qrellw/RR-Laser-Circuit/receiver/receiver-B_Cu_page-0001.jpg

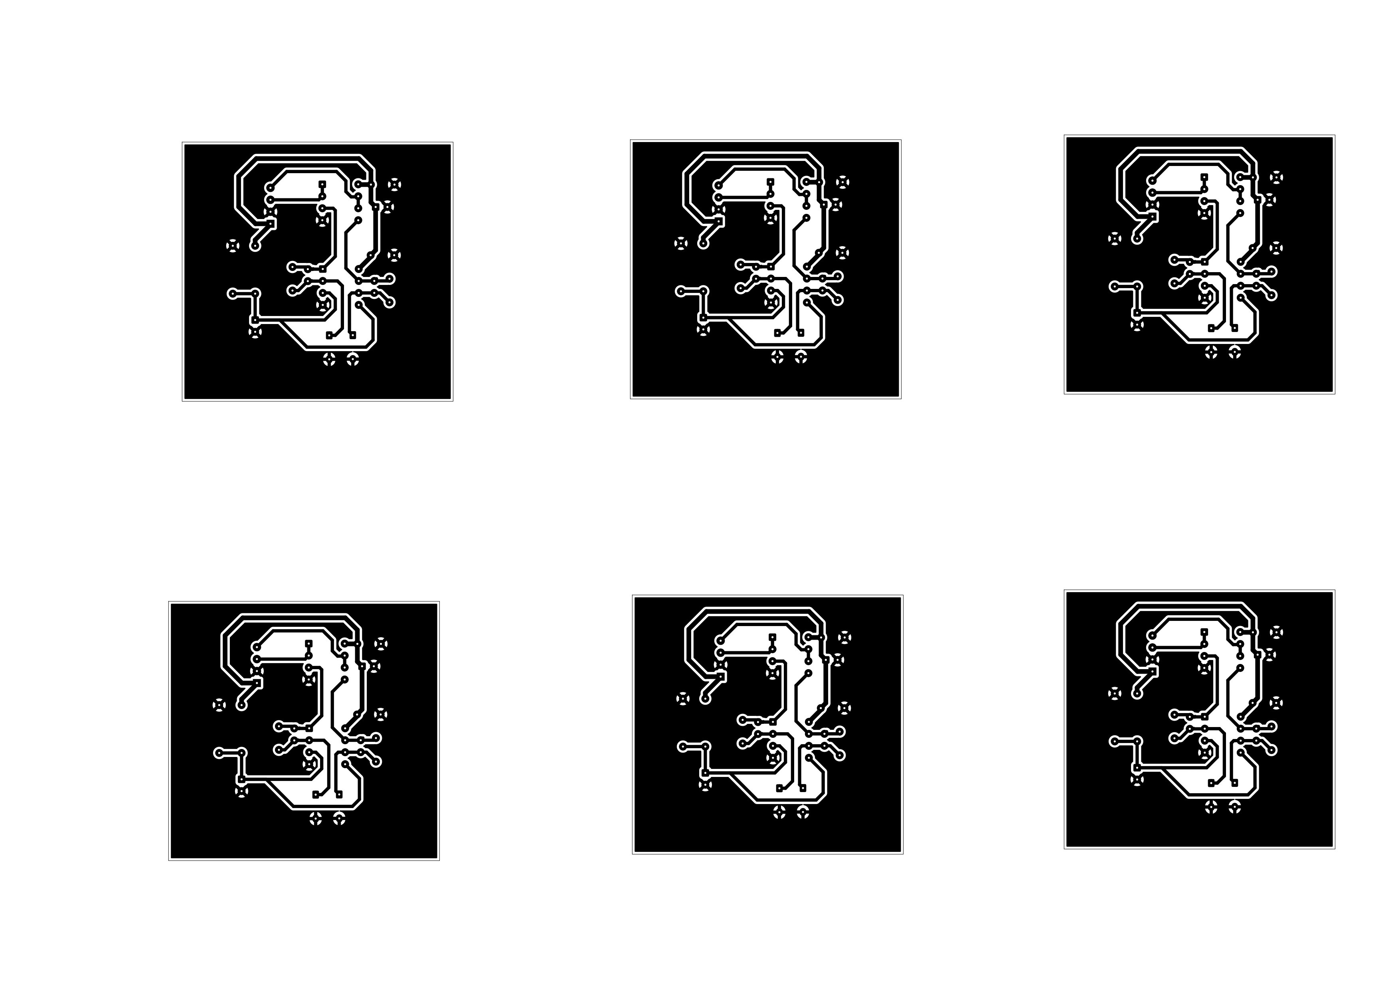
receiver/receiver-B_Cu_page-0001.jpg
