qrellw/RR-Laser-Circuit/receiver/bpw34-1.snapshot.1/bpw34.STEP

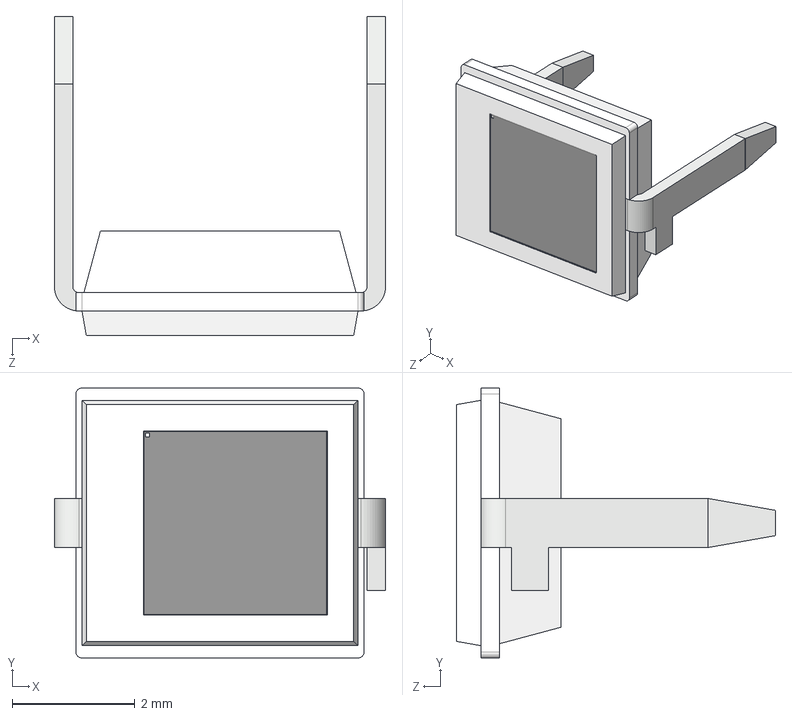
[picture p2: CAD file, 2026-10-17]
receiver/bpw34-1.snapshot.1/bpw34.STEP
5.40 x 4.40 x 5.20 mm
footA
footB
