qrellw/RR-Laser-Circuit/RR_Lightdistance/RR_Lightdistance.step

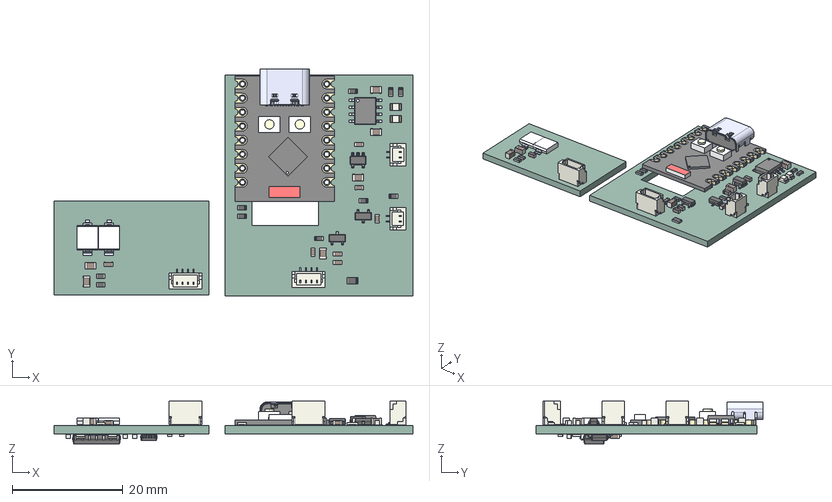
[picture p3: CAD file, 2026-10-30]
RR_Lightdistance/RR_Lightdistance.step
64.9 x 41.1 x 7.75 mm
C_0603_1608Metric x 12
JST_SH_BM02B-SRSS-TB_1x02-1MP_P1.00mm_Vertical x 2
C_0805_2012Metric x 6
SOT-23 x 2
R_0603_1608Metric x 16
BPW 34 S-Z x 2
R_0805_2012Metric
SOT-23-5
LED_0805_2012Metric x 2
Board c3mini
USB C
components (other)^ESP32-C3 SuperMini
TP4056-42-ESOP8
JST_SH_BM04B-SRSS-TB_1x04-1MP_P1.00mm_Vertical x 2
TSSOP-10_3x3mm_P0.5mm
SOIC-14_3.9x8.7mm_P1.27mm
RR_7F92_PCB_1
RR_7F92_PCB_2
