qrellw/RR-Laser-Circuit/(list of files, cad)

Other CAD files:
receiver/bpw34-1.snapshot.1/bpw34.SLDASM
