qrellw/RR-Laser-Circuit/receiver/receiver-B_Cu.pdf

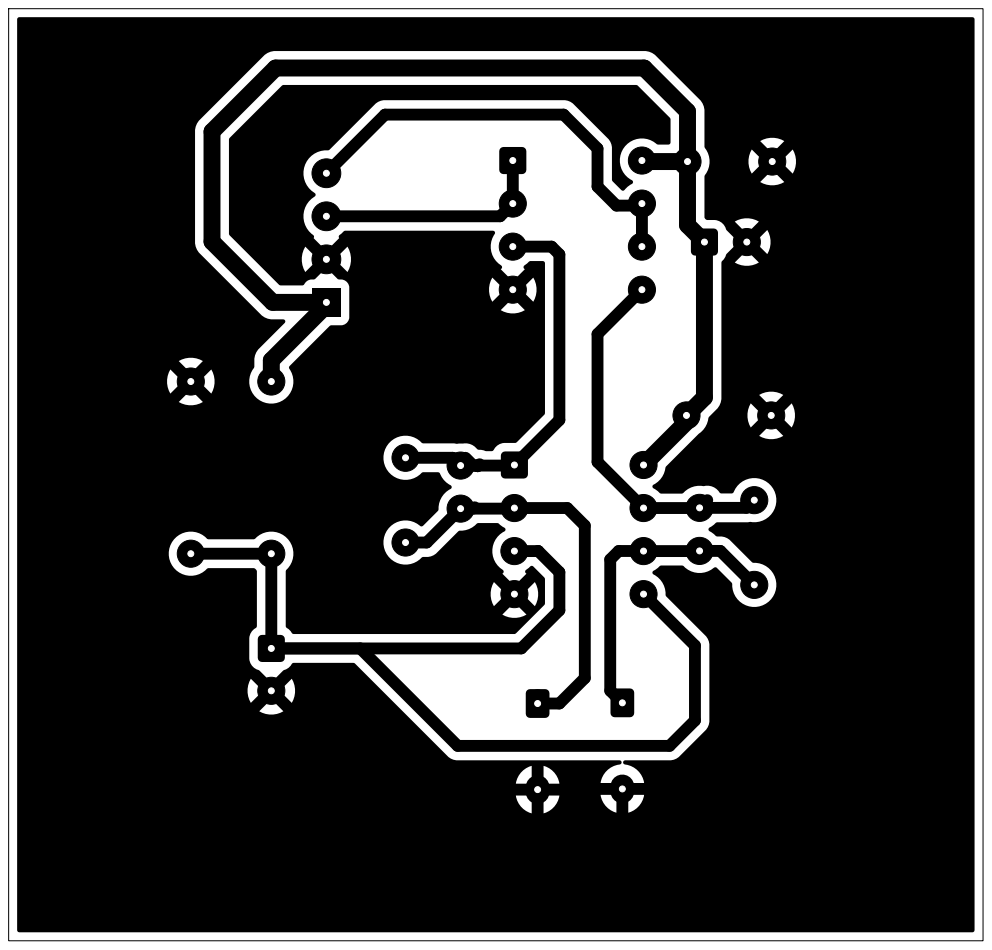
[picture p4: page 1]
