qrellw/RR-Laser-Circuit/RR_Lightdistance/RR_Lightdistance.kicad_pcb

## KiCad design RR_Lightdistance/RR_Lightdistance.kicad_pcb (2026-11-08)

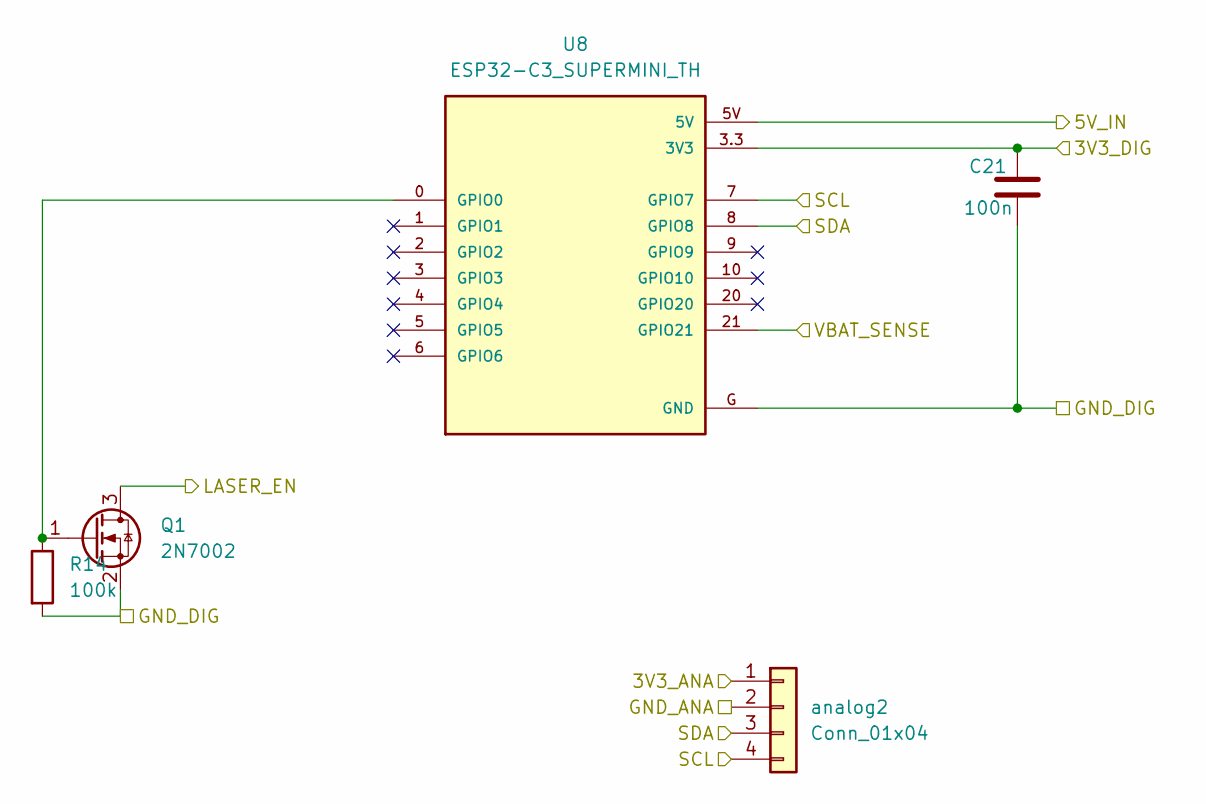
[picture p5: schematic digital.kicad_sch]

Parts:
C21: 100n; C_0603_1608Metric
Q1: 2N7002; SOT-23
R14: 100k; R_0603_1608Metric
U8: ESP32-C3_SUPERMINI_TH; MODULE_ESP32-C3_SUPERMINI_TH
analog2: Conn_01x04; JST_SH_BM04B-SRSS-TB_1x04-1MP_P1.00mm_Vertical

Connections:
/Analog/3V3_ANA: analog2.1; also elsewhere on the board
/Analog/GND_ANA: analog2.2; also elsewhere on the board
/Analog/SCL: U8.7 (GPIO7), analog2.4; also elsewhere on the board
/Analog/SDA: U8.8 (GPIO8), analog2.3; also elsewhere on the board
/Digital/3V3_DIG: C21.1, U8.3.3 (3V3); also elsewhere on the board
/Digital/5V_IN: U8.5V; also elsewhere on the board
/Digital/GND_DIG: C21.2, Q1.2 (S), R14.2, U8.G (GND); also elsewhere on the board
/Digital/LASER_EN: Q1.3 (D); also elsewhere on the board
/Digital/VBAT_SENSE: U8.21 (GPIO21); also elsewhere on the board
unnamed: Q1.1 (G), R14.1, U8.0 (GPIO0)

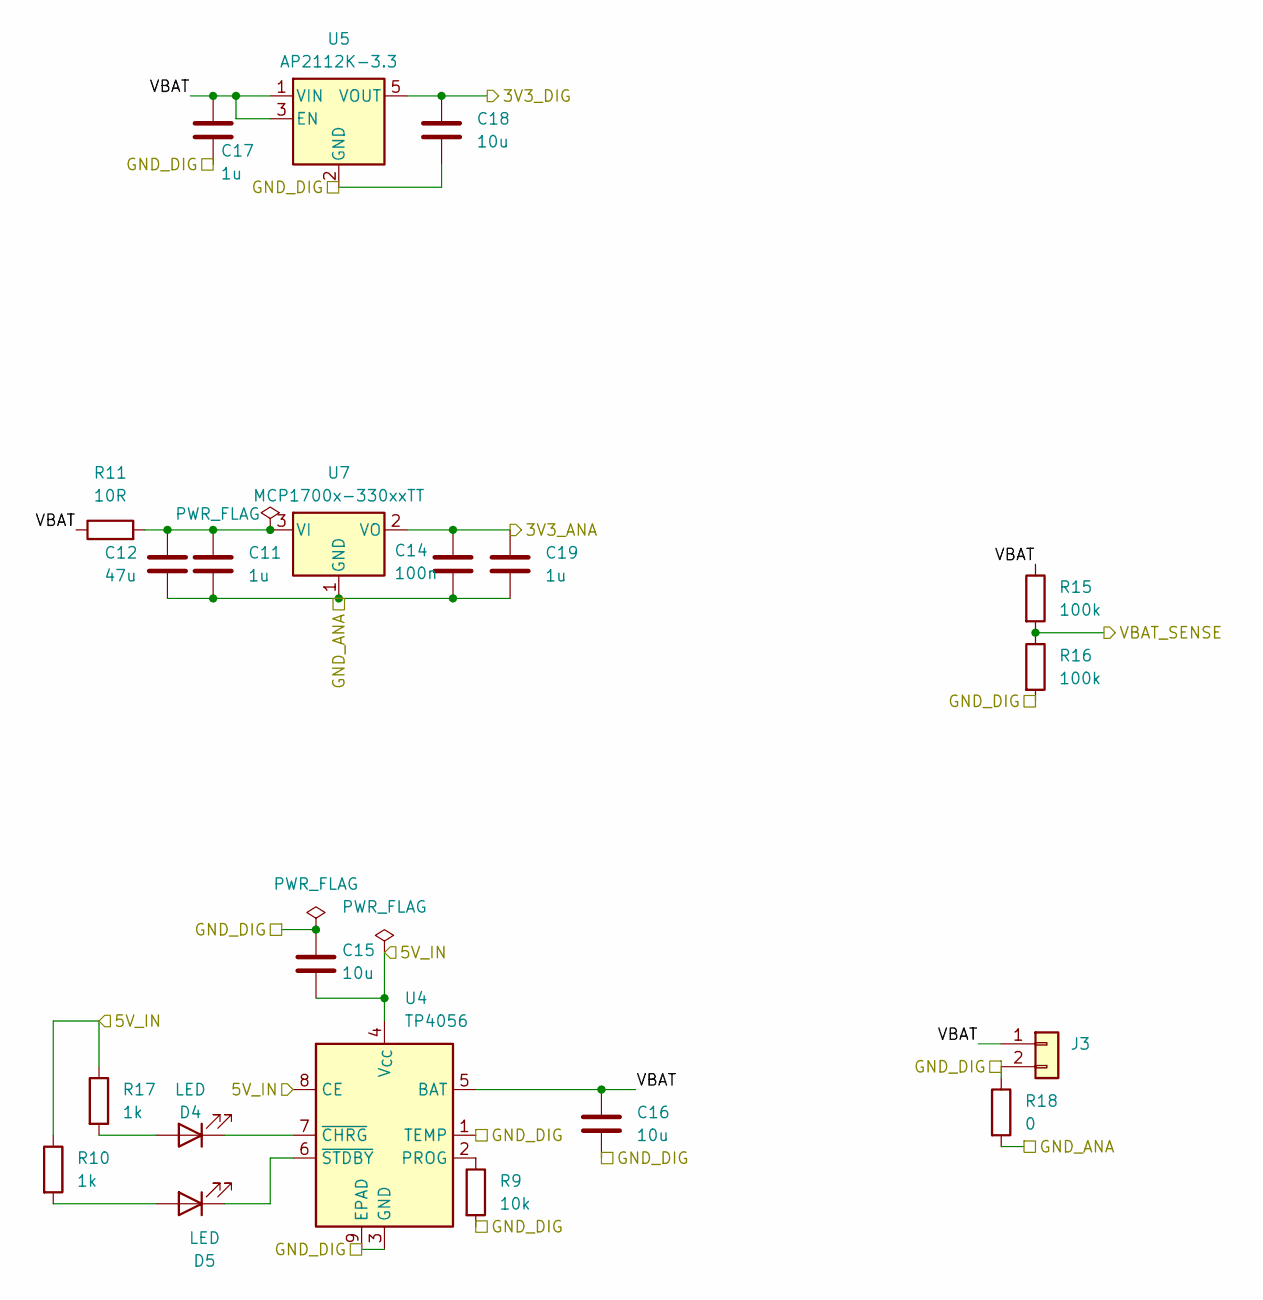
[picture p6: schematic power.kicad_sch]

Parts:
C11, C17, C19: 1u; C_0603_1608Metric
C12: 47u; C_0805_2012Metric
C14: 100n; C_0603_1608Metric
C15, C16, C18: 10u; C_0805_2012Metric
D4, D5: LED; LED_0805_2012Metric
J3: JST_SH_BM02B-SRSS-TB_1x02-1MP_P1.00mm_Vertical
R9: 10k; R_0603_1608Metric
R10, R17: 1k; R_0603_1608Metric
R11: 10R; R_0603_1608Metric
R15, R16: 100k; R_0603_1608Metric
R18: 0; R_0805_2012Metric
U4: TP4056; SOIC-8-1EP_3.9x4.9mm_P1.27mm_EP2.41x3.3mm_ThermalVias
U5: AP2112K-3.3; SOT-23-5
U7: MCP1700x-330xxTT; SOT-23

Connections:
/Analog/3V3_ANA: C14.1, C19.1, U7.2 (VO); also elsewhere on the board
/Analog/GND_ANA: C11.2, C12.2, C14.2, C19.2, R18.2, U7.1 (GND); also elsewhere on the board
/Digital/3V3_DIG: C18.1, U5.5 (VOUT); also elsewhere on the board
/Digital/5V_IN: C15.2, R10.1, R17.1, U4.4 (V_{CC}), U4.8 (CE); also elsewhere on the board
/Digital/GND_DIG: C15.1, C16.2, C17.2, C18.2, J3.2, R9.2, R16.2, R18.1, U4.1 (TEMP), U4.3 (GND), U4.9 (EPAD), U5.2 (GND); also elsewhere on the board
/Digital/VBAT_SENSE: R15.2, R16.1; also elsewhere on the board
/Power/VBAT: C16.1, C17.1, J3.1, R11.1, R15.1, U4.5 (BAT), U5.1 (VIN), U5.3 (EN)
unnamed: D4.2 (A), R17.2
unnamed: D4.1 (K), U4.7 (~CHRG)
unnamed: D5.2 (A), R10.2
unnamed: D5.1 (K), U4.6 (~STDBY)
unnamed: R9.1, U4.2 (PROG)
unnamed: C11.1, C12.1, R11.2, U7.3 (VI)

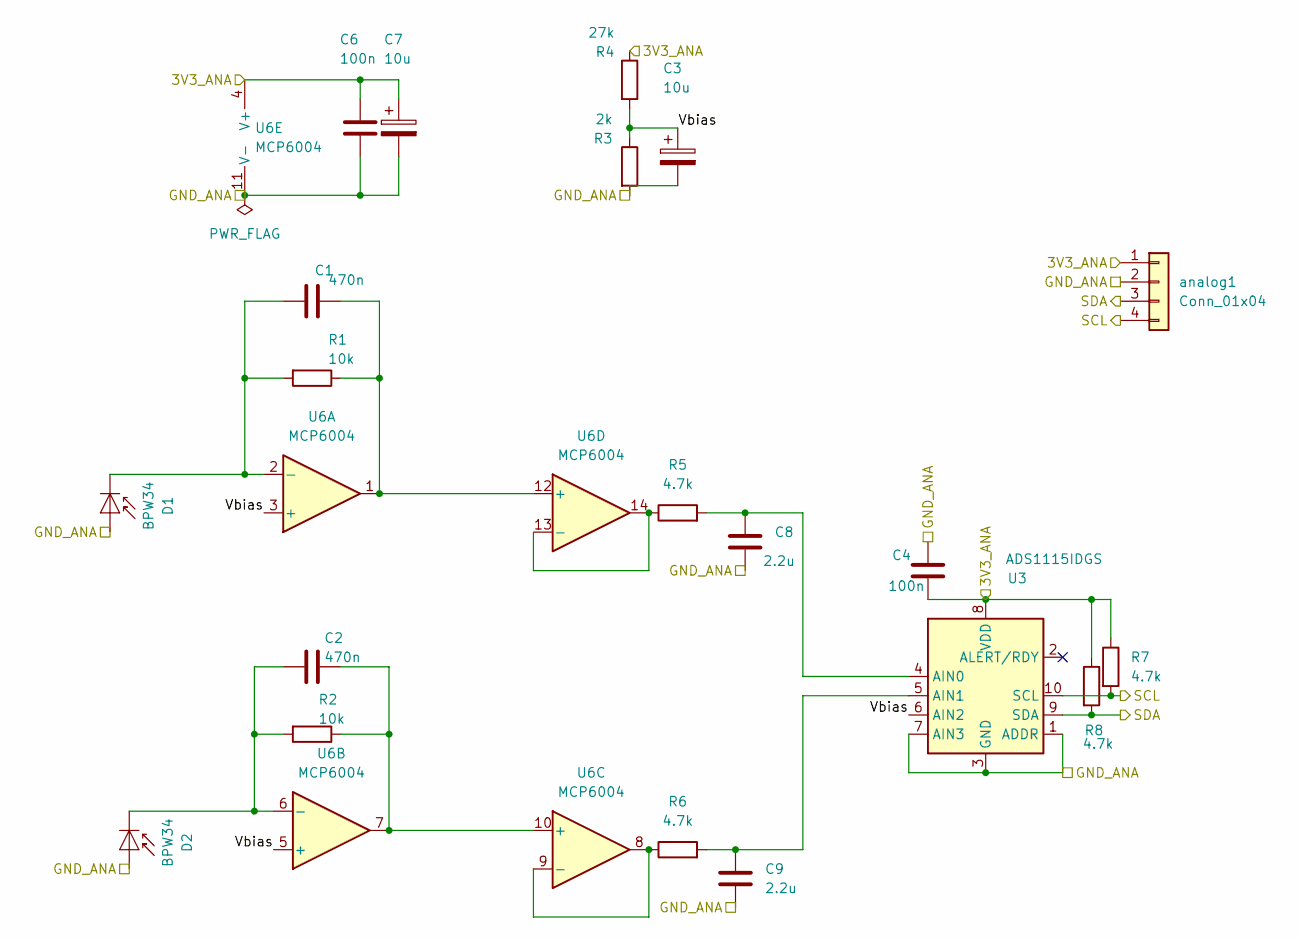
[picture p7: schematic analog.kicad_sch]

Parts:
C1, C2: 470n; C_0603_1608Metric
C3, C7: 10u; C_0805_2012Metric
C4, C6: 100n; C_0603_1608Metric
C8, C9: 2.2u; C_0603_1608Metric
D1, D2: BPW34; Osram_BPW34S-SMD
R1, R2: 10k; R_0603_1608Metric
R3: 2k; R_0603_1608Metric
R4: 27k; R_0603_1608Metric
R5, R6, R7, R8: 4.7k; R_0603_1608Metric
U3: ADS1115IDGS; TSSOP-10_3x3mm_P0.5mm
U6: MCP6004; SOIC-14_3.9x8.7mm_P1.27mm
analog1: Conn_01x04; JST_SH_BM04B-SRSS-TB_1x04-1MP_P1.00mm_Vertical

Connections:
/Analog/3V3_ANA: C4.2, C6.1, C7.1, R4.1, R7.1, R8.1, U3.8 (VDD), U6.4 (V+), analog1.1; also elsewhere on the board
/Analog/GND_ANA: C3.2, C4.1, C6.2, C7.2, C8.2, C9.2, D1.2 (A), D2.2 (A), R3.2, U3.1 (ADDR), U3.3 (GND), U3.7 (AIN3), U6.11 (V-), analog1.2; also elsewhere on the board
/Analog/SCL: R7.2, U3.10 (SCL), analog1.4; also elsewhere on the board
/Analog/SDA: R8.2, U3.9 (SDA), analog1.3; also elsewhere on the board
/Analog/Vbias: C3.1, R3.1, R4.2, U3.6 (AIN2), U6.3 (+), U6.5 (+)
unnamed: C1.2, D1.1 (K), R1.2, U6.2 (-)
unnamed: C2.2, D2.1 (K), R2.2, U6.6 (-)
unnamed: C8.1, R5.2, U3.4 (AIN0)
unnamed: C9.1, R6.2, U3.5 (AIN1)
unnamed: C2.1, R2.1, U6.7, U6.10 (+)
unnamed: R6.1, U6.8, U6.9 (-)
unnamed: C1.1, R1.1, U6.1, U6.12 (+)
unnamed: R5.1, U6.13 (-), U6.14

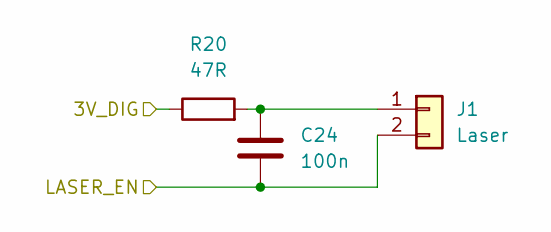
[picture p8: schematic laser.kicad_sch]

Parts:
C24: 100n; C_0603_1608Metric
J1: Laser; JST_SH_BM02B-SRSS-TB_1x02-1MP_P1.00mm_Vertical
R20: 47R; R_0603_1608Metric

Connections:
/Digital/3V3_DIG: R20.1; also elsewhere on the board
/Digital/LASER_EN: C24.2, J1.2; also elsewhere on the board
unnamed: C24.1, J1.1, R20.2

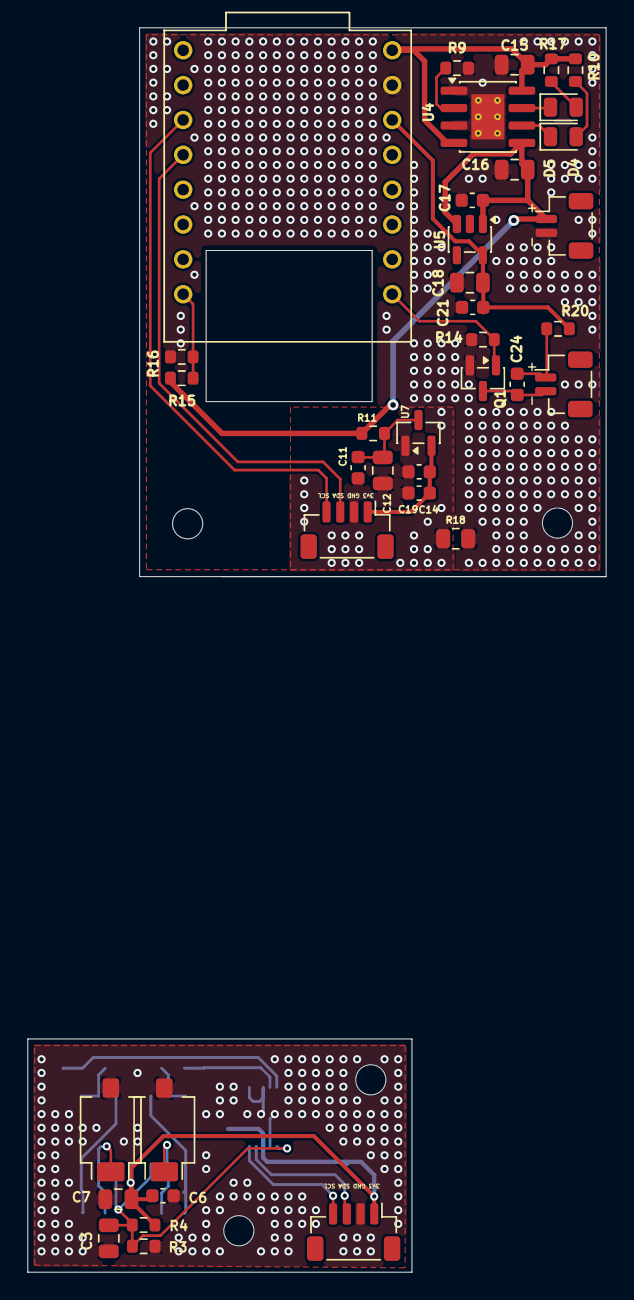
[picture p9: board RR_Lightdistance.kicad_pcb from above]

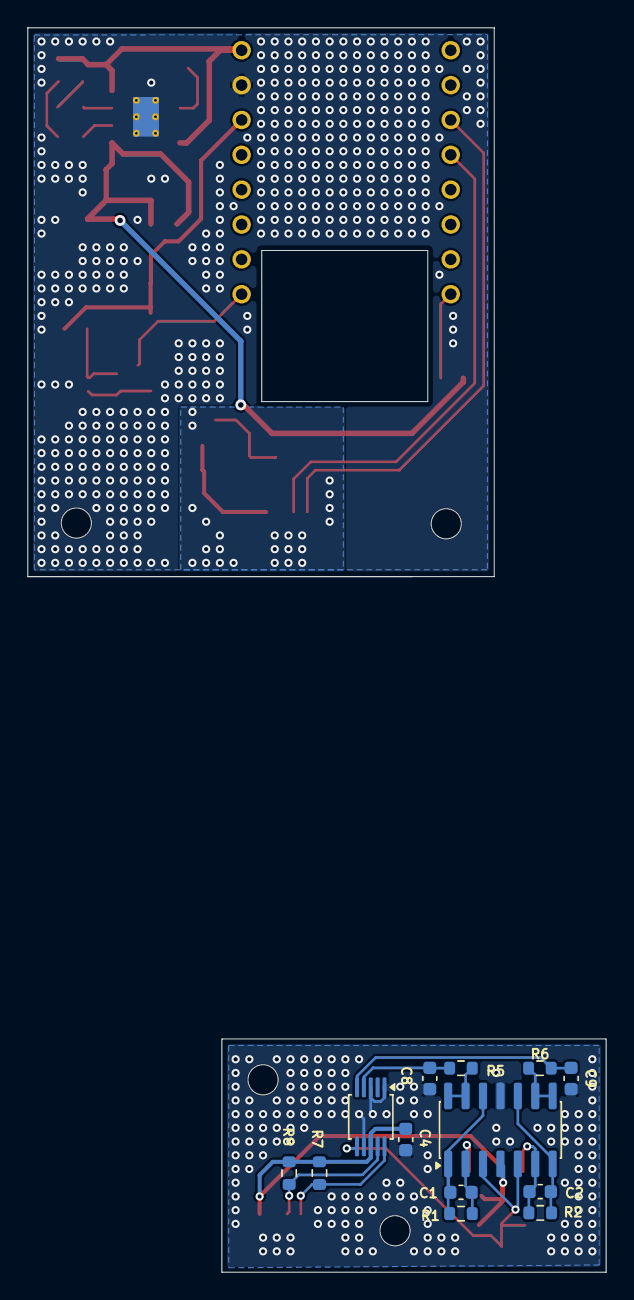
[picture p10: board RR_Lightdistance.kicad_pcb from below]

Board: 2 copper layers, 42.1 x 90.7 mm, 54 parts (13 on the bottom side), 27 nets.

Other parts of the board:
H1, H2, H3, H4: MountingHole_2.2mm_M2
