qrellw/RR-Laser-Circuit/receiver/receiver.kicad_pcb

## KiCad design receiver/receiver.kicad_pcb (2026-10-17)

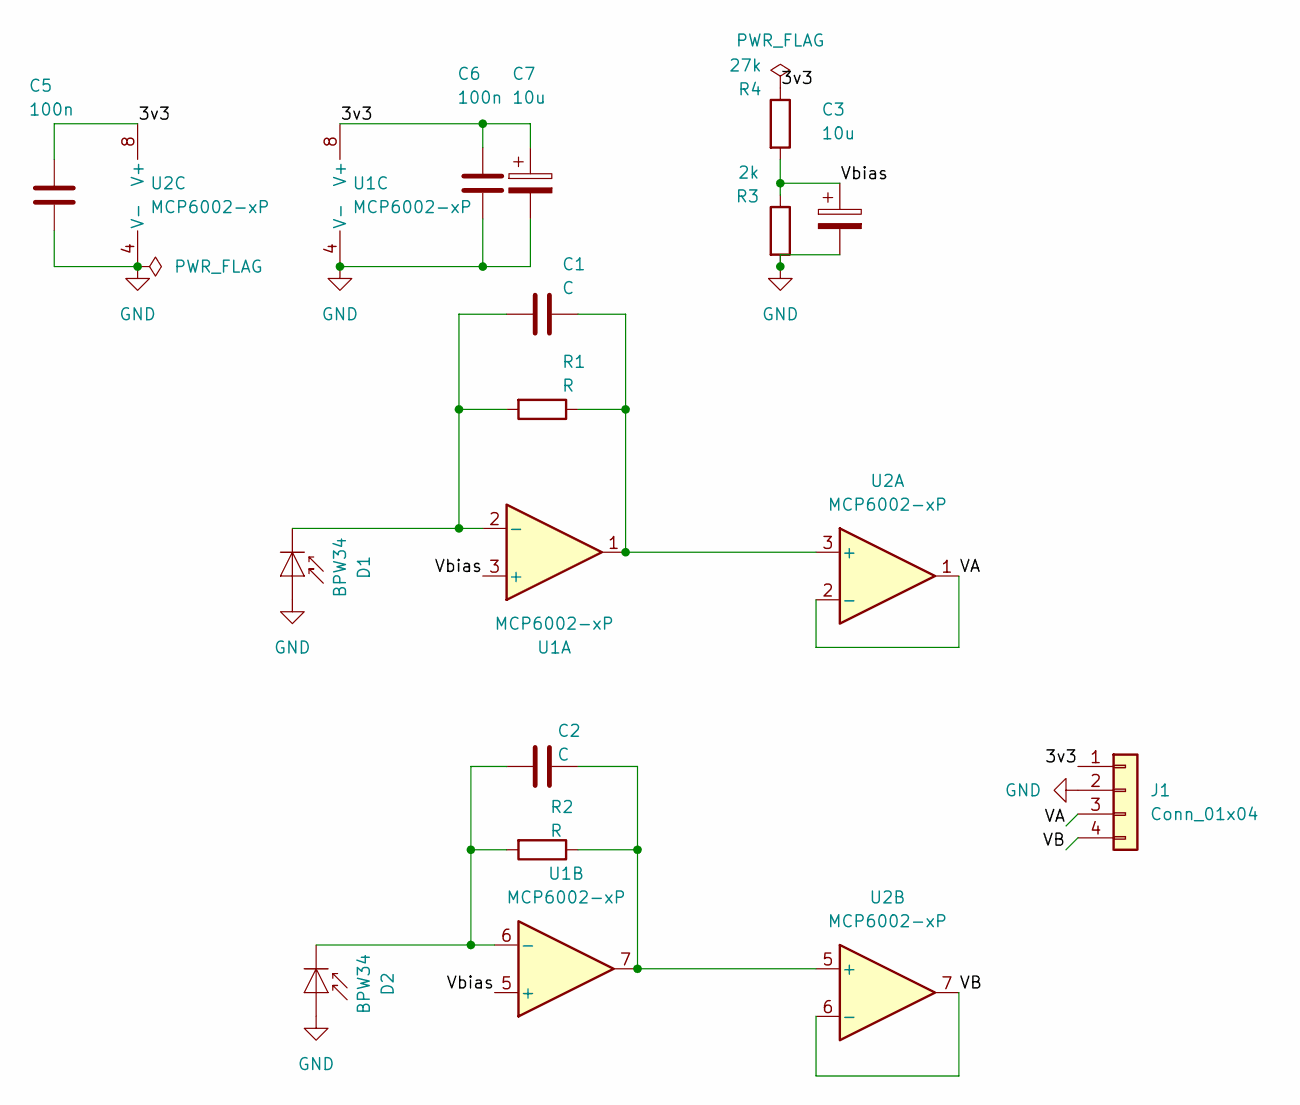
[picture p11: schematic receiver.kicad_sch]

Parts:
C1, C2: C; C_Disc_D5.0mm_W2.5mm_P5.00mm
C3, C7: 10u; CP_Radial_D5.0mm_P2.50mm
C5, C6: 100n; C_Disc_D5.0mm_W2.5mm_P5.00mm
D1, D2: BPW34; Osram_DIL2_4.3x4.65mm_P5.08mm
J1: Conn_01x04; PinHeader_1x04_P2.54mm_Vertical
R1, R2: R; R_Axial_DIN0207_L6.3mm_D2.5mm_P2.54mm_Vertical
R3: 2k; R_Axial_DIN0207_L6.3mm_D2.5mm_P10.16mm_Horizontal
R4: 27k; R_Axial_DIN0207_L6.3mm_D2.5mm_P10.16mm_Horizontal
U1, U2: MCP6002-xP; DIP-8_W7.62mm

Connections:
/3v3: C5.1, C6.1, C7.1, J1.1, R4.1, U1.8 (V+), U2.8 (V+)
/VA: J1.3, U2.1, U2.2 (-)
/VB: J1.4, U2.6 (-), U2.7
/Vbias: C3.1, R3.1, R4.2, U1.3 (+), U1.5 (+)
GND: C3.2, C5.2, C6.2, C7.2, D1.2 (A), D2.2 (A), J1.2, R3.2, U1.4 (V-), U2.4 (V-)
unnamed: C1.2, D1.1 (K), R1.2, U1.2 (-)
unnamed: C2.2, D2.1 (K), R2.2, U1.6 (-)
unnamed: C1.1, R1.1, U1.1, U2.3 (+)
unnamed: C2.1, R2.1, U1.7, U2.5 (+)

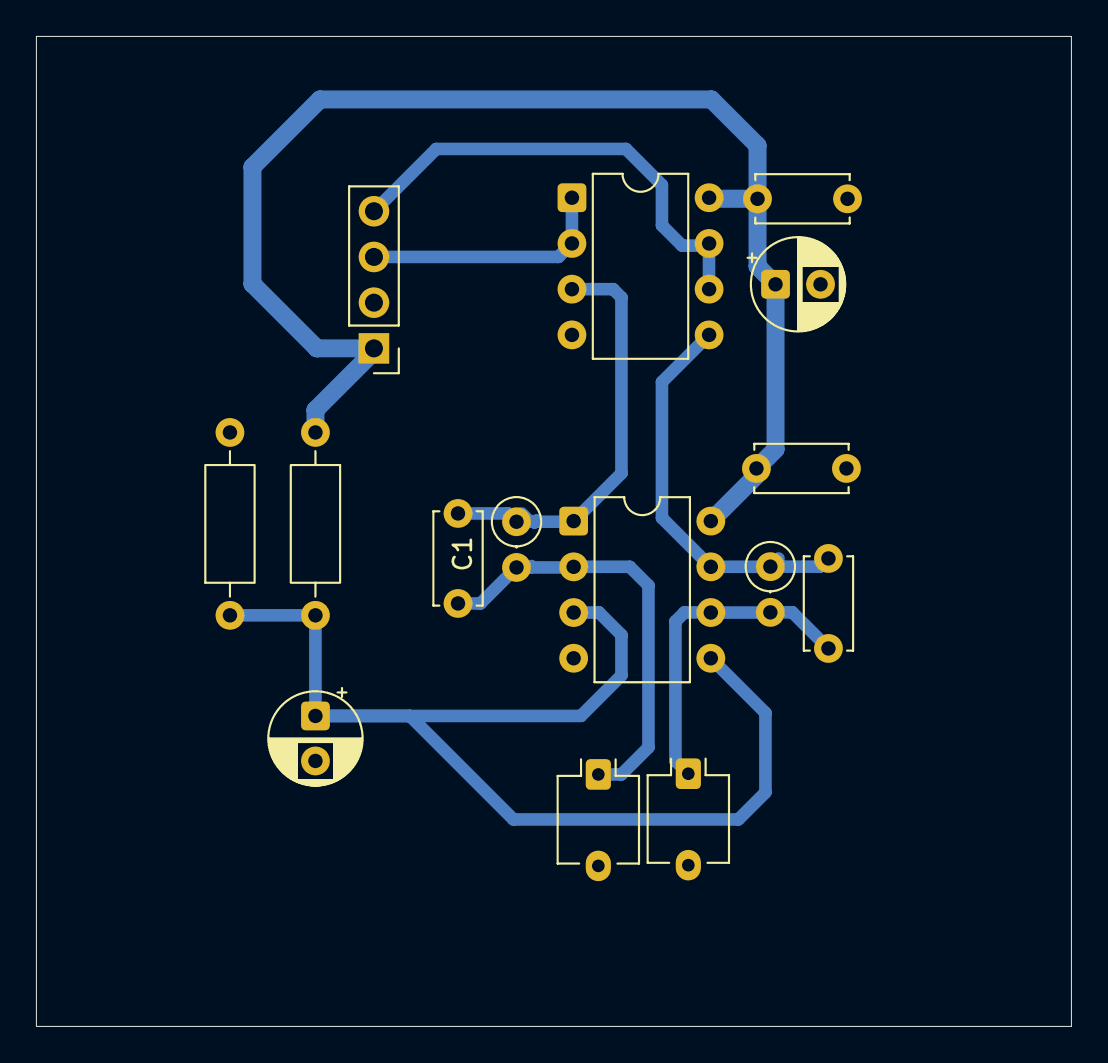
[picture p12: board receiver.kicad_pcb from above]

Board: 2 copper layers, 57.5 x 55.0 mm, 15 parts (0 on the bottom side), 9 nets.
