qrellw/RR-Laser-Circuit/(commit log)

2026-10-22 schematic full
2026-10-26 starting pcb
